i7sid/SkyNet-Dongle/bootloader/README.md

General Information
===================
This bootloader is based on
[openlpc-USB_Bootloader](https://github.com/openxc/openlpc-USB_Bootloader).

Some unnecessary parts where stripped off.
If you are looking for examples and openocd configuration,
please refer to openxc's repository.

All submodules have been included to simplify repository cloning and setup process.

For convenience a binary was added, that can be flashed directly onto LPC1769
even if there is no working arm toolchain installed.

You can simply flash the binary at  `src/bootloader.bin` to the device.
Afterwards the device should be detected by a host computer as a mass storage device.
Simply delete the file `firmware.bin` and upload another user application
(compiled for example with LPCXpresso IDE) in `bin`-format.
After resetting the device by unplugging and reinserting it the user application
should be executed.

All information from original repository following:

openlpc-USB_Bootloader
======================

This repository contains a USB bootloader compatible with the LPC17xx
microcontroller. The lineage of this bootloader:

* Originally based off of NXP's [AN10866 LPC1700 secondary
  bootloader](http://www.lpcware.com/content/nxpfile/an10866-lpc1700-secondary-usb-bootloader)
* Code Red modified the bootloader to use the BSD licensed LPCUSB library,
  instead of the restrictively licensed USB stack from Keil (which could only be
  used with the uVision/ARM development tools).
* Modifications made for OpenLPC project (not sure on the details)
* Chris Peplin replaced Code Red's fork of the LPCUSB library with a Git
  submodule pointing to a branch in the LPCUSB library that supports the
  LPC17xx, and re-used as many example files from the LPCUSB project directly.
* Chris also replaced the startup files with a Git submodule pointer to the ARM
  CDL project.
* Chris fixed an bug with non-sequntial writes that would break large-ish
  firmware writes.
* Chris added workarounds to allow flashing from all platforms from the CLI or a
  file browser (it's not exactly pretty, but it works - comments inline about
  the specific workarounds).

## Installing the Bootloader

    $ script/bootstrap.sh
    $ cd src
    $ make

Assuming you have an Olimex ARM-OCD-USB JTAG adapter plugged in, connected to
the board and the board powered up:

    $ make flash

If you are using an Olimex ARM-USB-OCD-H JTAG adapter, you need to specify a different interface:

    $ JTAG_INTERFACE=olimex-arm-usb-ocd-h make flash

## Building User Firmware

See the simple program in the `example` directory for an example of how to build
a program for the bootloader.

The only change required is your linker script - instead of starting the user
program at flash memory location 0, start it at `0x10000`, e.g.:

    FLASH (rx) : ORIGIN = 0x10000, LENGTH = 512K - 0x10000

If you are using the `SystemInit()` function from the ARM CDL, be aware that it
sets the vector table offset register (`VTOR`) back to `0`, so interrupts will
not work. A workaround is to manually set the `VTOR` to the location of your
interrupt vectors at startup:

    void Reset_Handler(void) {
        SystemInit();
        SCB->VTOR = (uint32_t) interrupt_vectors;
        ...
    }

This workaround doesn't have any negative effects if you use the same code
running on bare metal.

## Flashing User Code

Note that the `firmware.bin` file will always look the same (with an old
modification date and the same `firmware.bin` filename), even if you reflash and
remount the bootloader. It's not a true filesystem, we are just creating a fake
file so you can write to it from standard file browser tools.

### Windows

To flash, hold down the bootloader entry button while plugging into USB or
hitting the reset button. A USB drive should appear.

* Delete the firmware.bin file
* Copy your new firmware.bin over (the filename doesn't matter)
* Unmount and reset the microcontroller

### Mac OS X

To flash, hold down the bootloader entry button while plugging into USB or
hitting the reset button. A USB drive should appear.

**Using Finder**

* Delete the firmware.bin file
* Copy your new firmware.bin over (the filename doesn't matter)
* Eject and reset the microcontroller

**Command Line**

Open the Terminal app and run this to update the
firmware, assuming the file "newfirmware.bin" is in the current
directory and is the new version of the firmware you want to flash:

  $ cp newfirmware.bin /Volumes/LPC1759/firmware.bin

Eject and reset the microcontroller.

### Linux

There are two good options for flashing user firmware from Linux.

**USB Drive Method**

To flash, hold down the bootloader entry button while plugging into USB or
hitting the reset button. A USB drive should appear in your file manager (or you
can mount it manually with the `vfat` filesystem type).

* Delete the firmware.bin file
* Copy your new firmware.bin over (the filename doesn't matter)
* Unmount and reset the microcontroller

(These instructions are the same as Windows.)

Mounting the USB disk drive, deleting firmware.bin and copying over the new file
works fine now (after some bug fixes in the [original version of this
bootloader](http://dangerousprototypes.com/docs/LPC_ARM_quick_start#Bootloaders).

## License

The LPCUSB library is made availble under the BSD license. It is linked to from
this project as a Git submodule.

The core of the bootloader is originally developed by NXP, and is licensed under
NXP's odd example code license:

    Software that is described herein is for illustrative purposes only
    which provides customers with programming information regarding the
    products. This software is supplied "AS IS" without any warranties.
    NXP Semiconductors assumes no responsibility or liability for the
    use of the software, conveys no license or title under any patent,
    copyright, or mask work right to the product. NXP Semiconductors
    reserves the right to make changes in the software without
    notification. NXP Semiconductors also make no representation or
    warranty that such application will be suitable for the specified
    use without further testing or modification.

NXP claims no liability, but "conveys no license" which makes it not really open
source. Representatives of NXP have publicly stated that they are OK with the
examples being used and redistributed, so we use it here in good faith
([source](http://knowledgebase.nxp.com/showthread.php?t=2514&langid=2)).

A few remaining lines of code within other files pieces were developed by Code
Red, and are possibly available under a more restrictive license:

    The software is owned by Code Red Technologies and/or its suppliers, and is
    protected under applicable copyright laws.  All rights are reserved.  Any
    use in violation of the foregoing restrictions may subject the user to criminal
    sanctions under applicable laws, as well as to civil liability for the breach
    of the terms and conditions of this license.

    THIS SOFTWARE IS PROVIDED "AS IS".  NO WARRANTIES, WHETHER EXPRESS, IMPLIED
    OR STATUTORY, INCLUDING, BUT NOT LIMITED TO, IMPLIED WARRANTIES OF
    MERCHANTABILITY AND FITNESS FOR A PARTICULAR PURPOSE APPLY TO THIS SOFTWARE.
    USE OF THIS SOFTWARE FOR COMMERCIAL DEVELOPMENT AND/OR EDUCATION IS SUBJECT
    TO A CURRENT END USER LICENSE AGREEMENT (COMMERCIAL OR EDUCATIONAL) WITH
    CODE RED TECHNOLOGIES LTD.

Code Red has taken a public position that they are fine with redistributing the
code and including it in products, as long as the copyright message remains
intact so we use it here in good faith
([source](http://knowledgebase.nxp.trimm.net/showthread.php?p=12830)).
