i7sid/SkyNet-Dongle/case/v3.1.lowerCase.stl

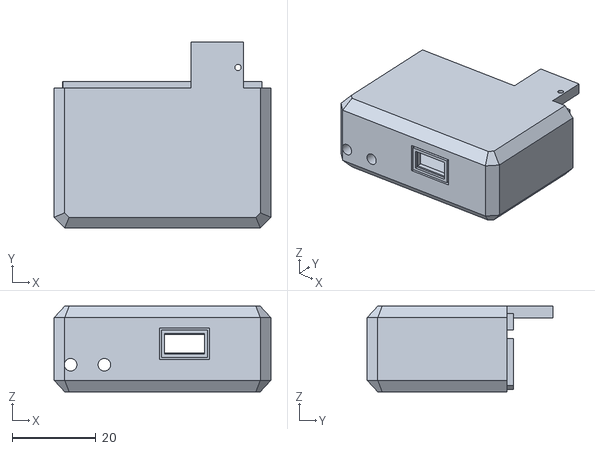
[picture p1: CAD file, 2015-02-09]
case/v3.1.lowerCase.stl
51.7 x 44.4 x 20.4
