i7sid/SkyNet-Dongle/case/v3.1.upperCase.stl

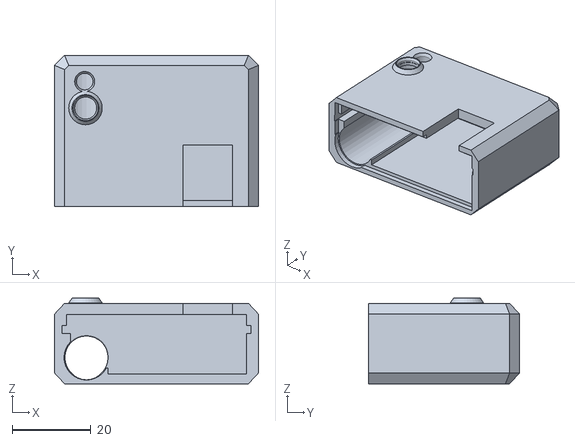
[picture p2: CAD file, 2015-02-09]
case/v3.1.upperCase.stl
51.7 x 38.4 x 21.7
