i7sid/SkyNet-Dongle/case/v3.1.button.stl

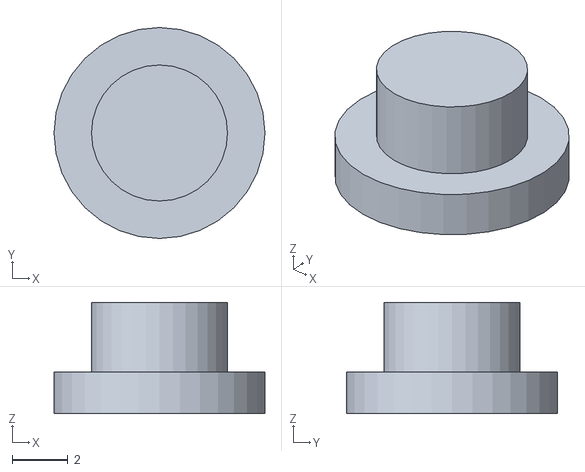
[picture p3: CAD file, 2015-01-29]
case/v3.1.button.stl
7.60 x 7.60 x 4.00
