i7sid/SkyNet-Dongle/board/SkyNetV3.1.brd

## EAGLE design board/SkyNetV3.1.brd (2015-10-10)

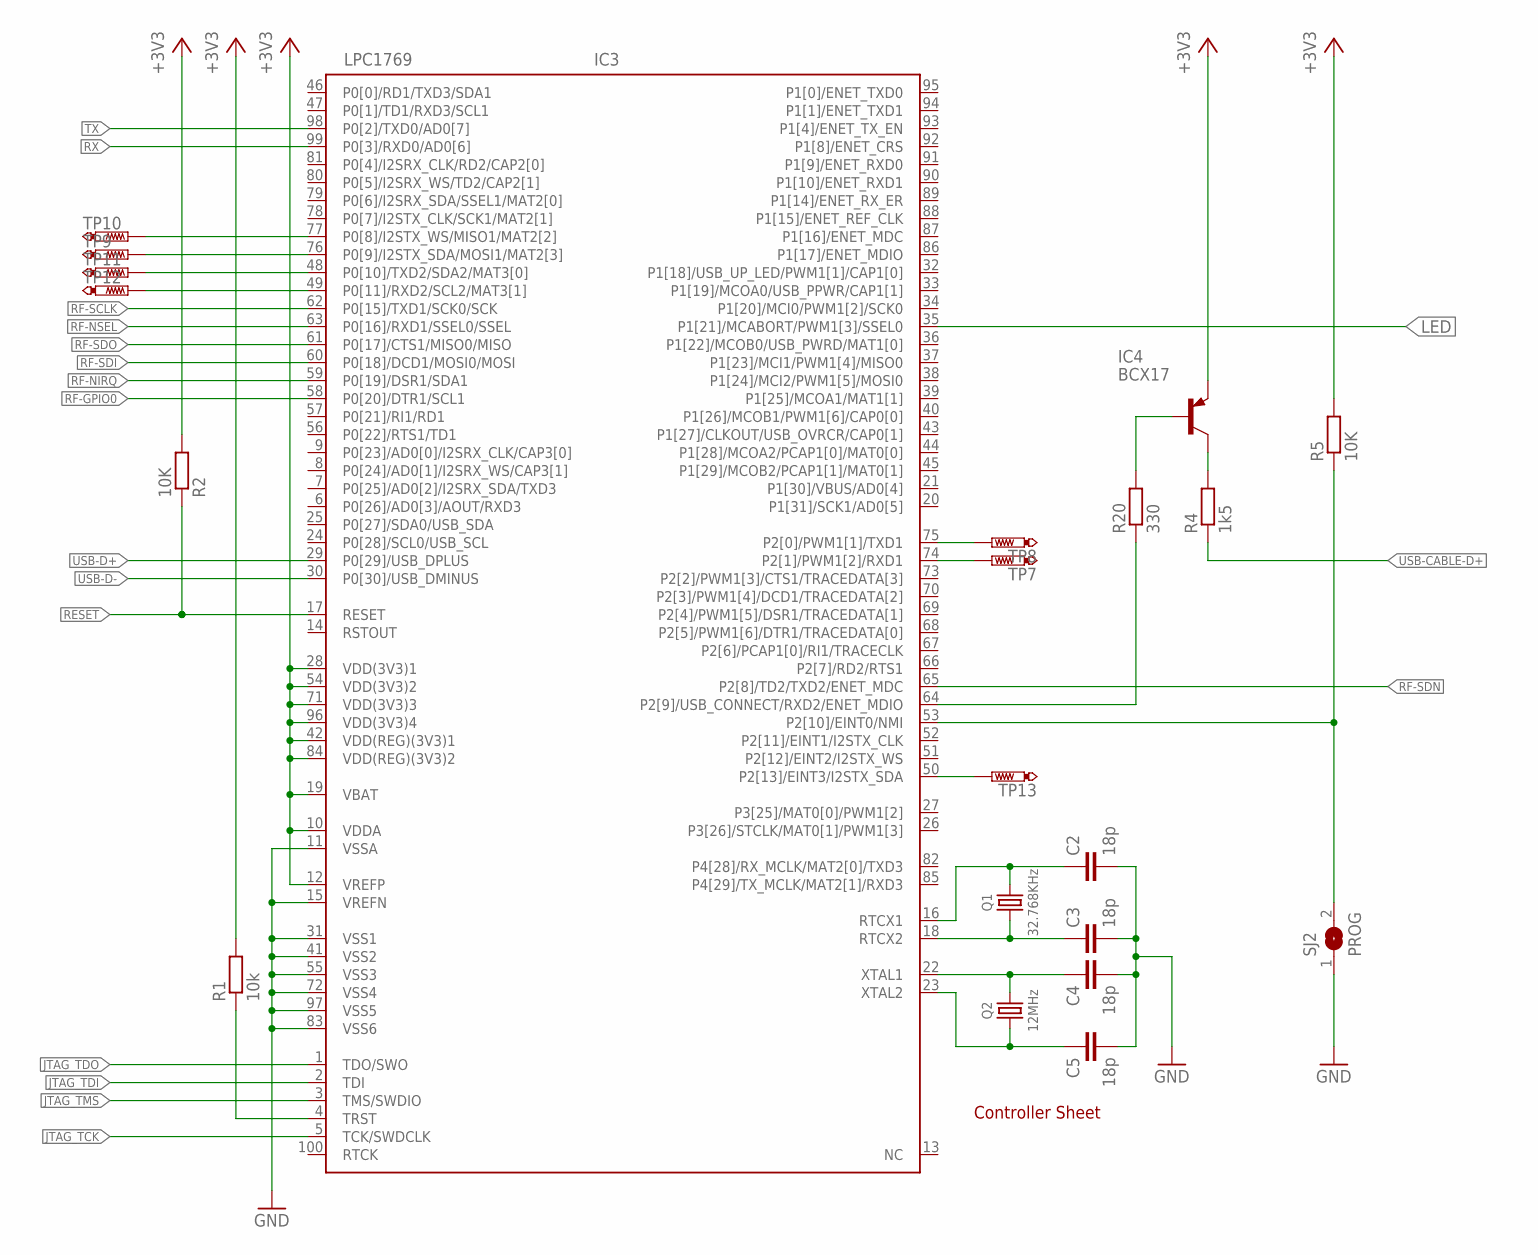
[picture p4: schematic SkyNetV3.1.sch, sheet 1, Controller]

Parts:
C2, C3, C4, C5: 18p; C0603
IC3: LPC1769; LQFP100-14X14
IC4: BCX17; SOT23
Q1: 32.768KHz; XTAL_49_18
Q2: 12MHz; XTAL_50_32
R1: 10k; R0603
R2, R5: 10K; R0603
R4: 1k5; R0603
R20: 330; R0603
SJ2: PROG; SJ
TP7, TP8, TP9, TP10, TP11, TP12, TP13: PTR1B1,27; B1,27

Connections:
+3V3: IC3.10 (VDDA), IC3.12 (VREFP), IC3.19 (VBAT), IC3.28 (VDD(3V3)1), IC3.42 (VDD(REG)(3V3)1), IC3.54 (VDD(3V3)2), IC3.71 (VDD(3V3)3), IC3.84 (VDD(REG)(3V3)2), IC3.96 (VDD(3V3)4), IC4.2 (E), R1.2, R2.2, R5.2; also elsewhere on the board
GND: C2.2, C3.2, C4.2, C5.2, IC3.11 (VSSA), IC3.15 (VREFN), IC3.31 (VSS1), IC3.41 (VSS2), IC3.55 (VSS3), IC3.72 (VSS4), IC3.83 (VSS6), IC3.97 (VSS5), SJ2.1; also elsewhere on the board
JTAG-TRST: IC3.4 (TRST), R1.1
JTAG_TCK: IC3.5 (TCK/SWDCLK); also elsewhere on the board
JTAG_TDI: IC3.2 (TDI); also elsewhere on the board
JTAG_TDO: IC3.1 (TDO/SWO); also elsewhere on the board
JTAG_TMS: IC3.3 (TMS/SWDIO); also elsewhere on the board
LED: IC3.35 (P1[21]/MCABORT/PWM1[3]/SSEL0); also elsewhere on the board
unnamed: IC3.75 (P2[0]/PWM1[1]/TXD1), TP8.TP
unnamed: IC3.76 (P0[9]/I2STX_SDA/MOSI1/MAT2[3]), TP9.TP
unnamed: IC3.77 (P0[8]/I2STX_WS/MISO1/MAT2[2]), TP10.TP
unnamed: IC3.74 (P2[1]/PWM1[2]/RXD1), TP7.TP
unnamed: IC3.49 (P0[11]/RXD2/SCL2/MAT3[1]), TP12.TP
unnamed: IC3.48 (P0[10]/TXD2/SDA2/MAT3[0]), TP11.TP
unnamed: IC3.50 (P2[13]/EINT3/I2STX_SDA), TP13.TP
PROG: IC3.53 (P2[10]/EINT0/NMI), R5.1, SJ2.2
RESET: IC3.17 (RESET), R2.1; also elsewhere on the board
RF-GPIO0: IC3.58 (P0[20]/DTR1/SCL1); also elsewhere on the board
RF-NIRQ: IC3.59 (P0[19]/DSR1/SDA1); also elsewhere on the board
RF-NSEL: IC3.63 (P0[16]/RXD1/SSEL0/SSEL); also elsewhere on the board
RF-SCLK: IC3.62 (P0[15]/TXD1/SCK0/SCK); also elsewhere on the board
RF-SDI: IC3.60 (P0[18]/DCD1/MOSI0/MOSI); also elsewhere on the board
RF-SDN: IC3.65 (P2[8]/TD2/TXD2/ENET_MDC); also elsewhere on the board
RF-SDO: IC3.61 (P0[17]/CTS1/MISO0/MISO); also elsewhere on the board
RTCX1: C2.1, IC3.16 (RTCX1), Q1.2
RTCX2: C3.1, IC3.18 (RTCX2), Q1.1
RX: IC3.99 (P0[3]/RXD0/AD0[6]); also elsewhere on the board
TX: IC3.98 (P0[2]/TXD0/AD0[7]); also elsewhere on the board
USB-CABLE-D+: R4.1; also elsewhere on the board
USB-CON: IC3.64 (P2[9]/USB_CONNECT/RXD2/ENET_MDIO), R20.1
USB-CON-TRANS: IC4.1 (B), R20.2
USB-CON-TRANS-2: IC4.3 (C), R4.2
USB-D+: IC3.29 (P0[29]/USB_DPLUS); also elsewhere on the board
USB-D-: IC3.30 (P0[30]/USB_DMINUS); also elsewhere on the board
XTAL1: C4.1, IC3.22 (XTAL1), Q2.3 (2)
XTAL2: C5.1, IC3.23 (XTAL2), Q2.1

Notes on the sheet:
Controller Sheet

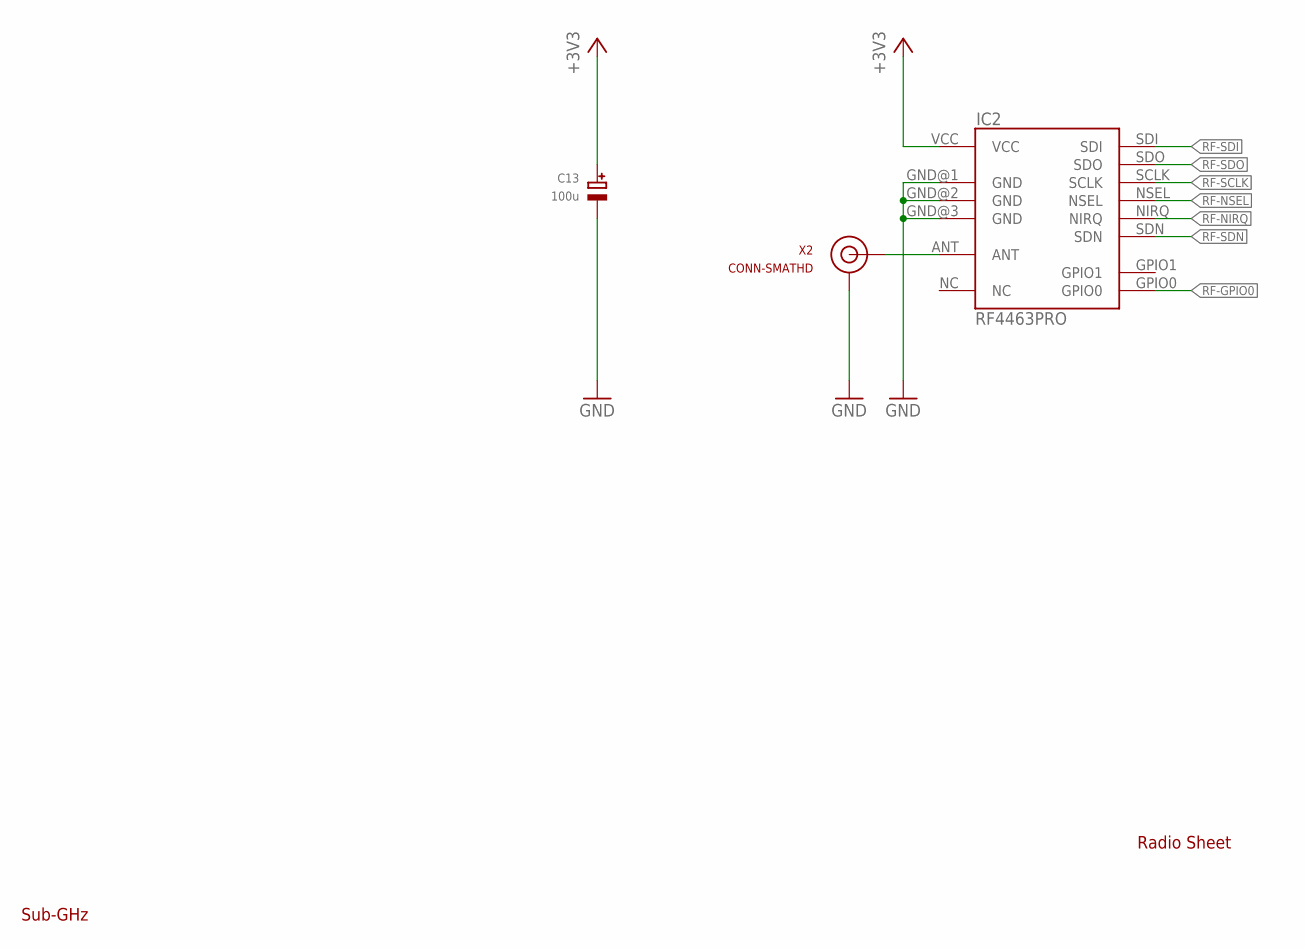
[picture p5: schematic SkyNetV3.1.sch, sheet 2, Radio]

Parts:
C13: 100u; EIA6032-28/C-W
IC2: RF4463PRO; STD_BOARD
X2: CONN-SMATHD; SMA-THD

Connections:
+3V3: C13.+, IC2.VCC; also elsewhere on the board
ANT: IC2.ANT, X2.SIG (SIGNAL)
GND: C13.-, IC2.GND@1 (GND), IC2.GND@2 (GND), IC2.GND@3 (GND), X2.GND@0 (GND), X2.GND@1 (GND), X2.GND@2 (GND), X2.GND@3 (GND); also elsewhere on the board
RF-GPIO0: IC2.GPIO0; also elsewhere on the board
RF-NIRQ: IC2.NIRQ; also elsewhere on the board
RF-NSEL: IC2.NSEL; also elsewhere on the board
RF-SCLK: IC2.SCLK; also elsewhere on the board
RF-SDI: IC2.SDI; also elsewhere on the board
RF-SDN: IC2.SDN; also elsewhere on the board
RF-SDO: IC2.SDO; also elsewhere on the board

Notes on the sheet:
Radio Sheet
Sub-GHz

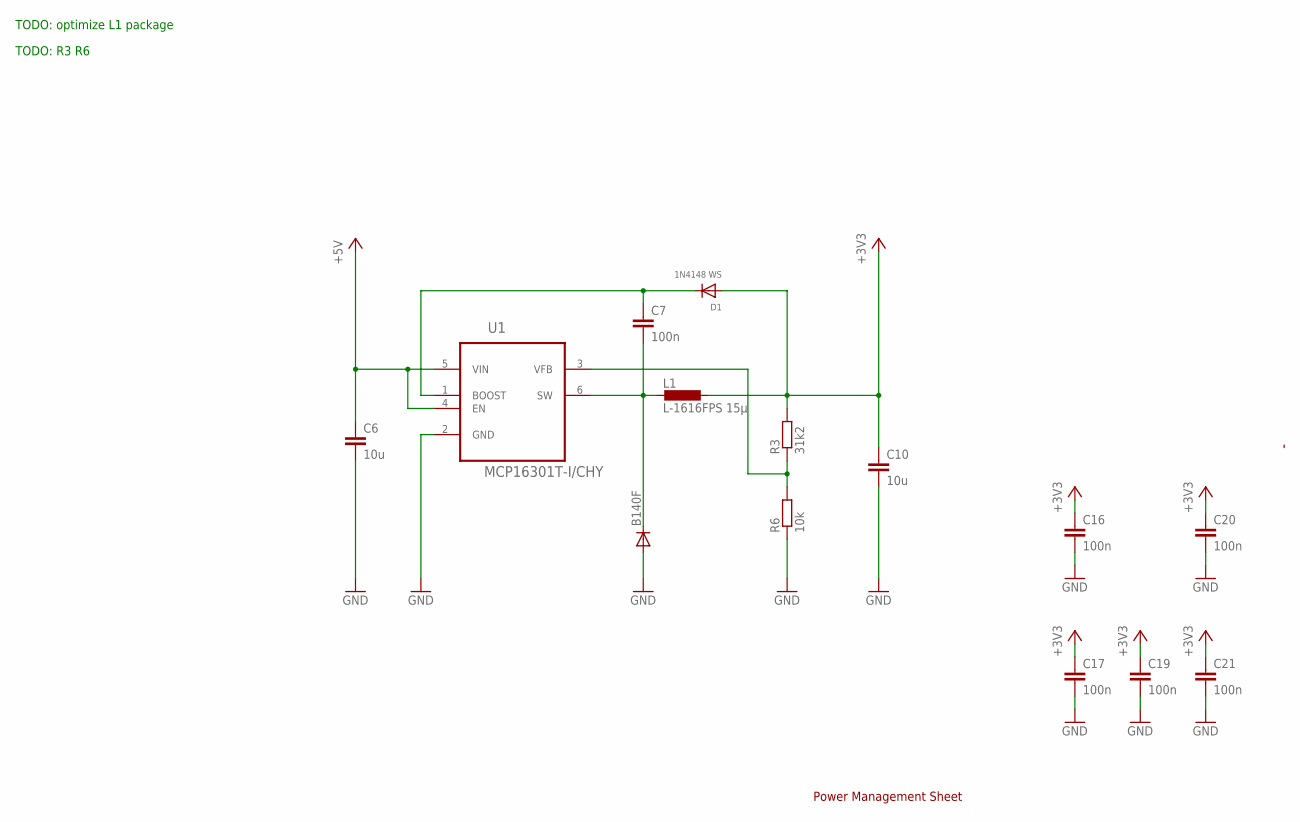
[picture p6: schematic SkyNetV3.1.sch, sheet 3, Power]

Parts:
B140F: DIODE-DO214AC; DO214AC
C6, C10: 10u; C0805
C7, C16, C17, C19, C20, C21: 100n; C0603
D1: 1N4148 WS; SOD-323
L1: L-1616FPS 15µ; LQH55D
R3: 31k2; R0603
R6: 10k; R0603
U1: MCP16301T-I/CHY; SOT95P290X145-6N

Connections:
+3V3: C10.1, C16.1, C17.1, C19.1, C20.1, C21.1, D1.A, L1.P$1 (1), R3.2; also elsewhere on the board
+5V: C6.1, U1.4 (EN), U1.5 (VIN); also elsewhere on the board
GND: B140F.A, C6.2, C10.2, C16.2, C17.2, C19.2, C20.2, C21.2, R6.1, U1.2 (GND); also elsewhere on the board
unnamed: B140F.C, C7.2, L1.P$2 (2), U1.6 (SW)
unnamed: C7.1, D1.C, U1.1 (BOOST)
unnamed: R3.1, R6.2, U1.3 (VFB)

Notes on the sheet:
Power Management Sheet
TODO: optimize L1 package
TODO: R3 R6

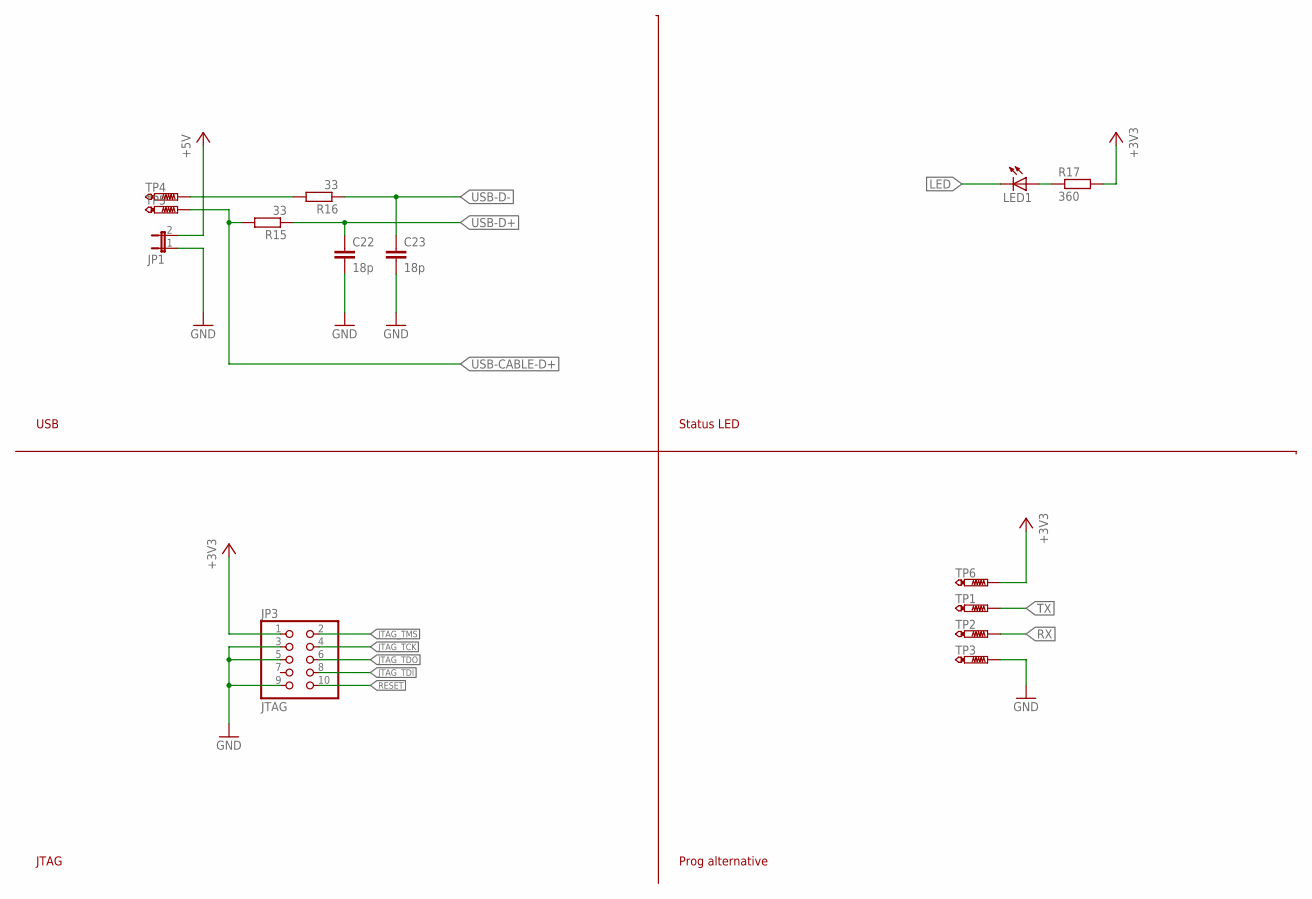
[picture p7: schematic SkyNetV3.1.sch, sheet 4, Interface]

Parts:
C22, C23: 18p; C0603
JP1: JP1E; JP1
JP3: JTAG; 2X05_1.27MM_SMT
LED1: LEDCHIP-LED0805; CHIP-LED0805
R15, R16: 33; R0603
R17: 360; R0603
TP1, TP2, TP4, TP5: PTR1B1,27; B1,27
TP3, TP6: PTR1B2,54; B2,54

Connections:
+3V3: JP3.1, R17.2, TP6.TP; also elsewhere on the board
+5V: JP1.2; also elsewhere on the board
GND: C22.2, C23.2, JP1.1, JP3.3, JP3.5, JP3.9, TP3.TP; also elsewhere on the board
JTAG_TCK: JP3.4; also elsewhere on the board
JTAG_TDI: JP3.8; also elsewhere on the board
JTAG_TDO: JP3.6; also elsewhere on the board
JTAG_TMS: JP3.2; also elsewhere on the board
LED: LED1.C; also elsewhere on the board
LED-R-R: LED1.A, R17.1
RESET: JP3.10; also elsewhere on the board
RX: TP2.TP; also elsewhere on the board
TX: TP1.TP; also elsewhere on the board
USB-CABLE-D+: R15.2, TP5.TP; also elsewhere on the board
USB-CABLE-D-: R16.2, TP4.TP
USB-D+: C22.1, R15.1; also elsewhere on the board
USB-D-: C23.1, R16.1; also elsewhere on the board

Notes on the sheet:
USB
Status LED
Prog alternative
JTAG

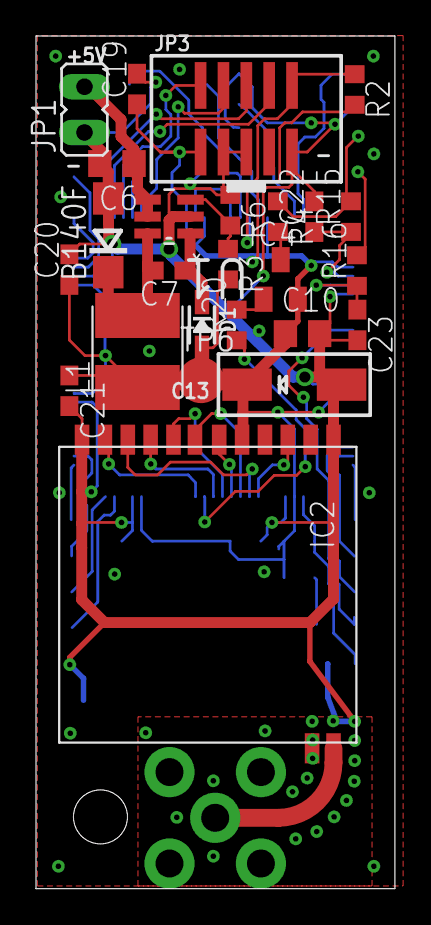
[picture p8: board SkyNetV3.1.brd from above]

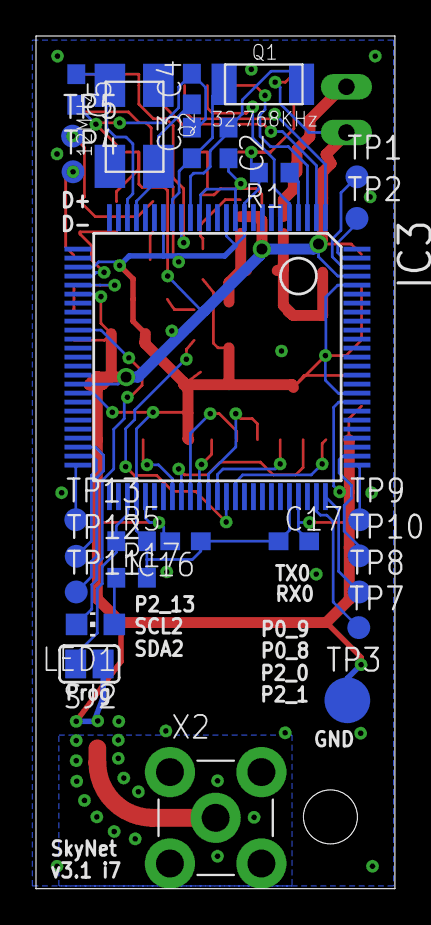
[picture p9: board SkyNetV3.1.brd from below]

Board: 2 copper layers, 19.9 x 47.4 mm, 52 parts (27 on the bottom side), 43 nets.
