i7sid/SkyNet-Dongle/board_breakout/board_breakout.brd

## EAGLE design board_breakout/board_breakout.brd (2015-02-02)

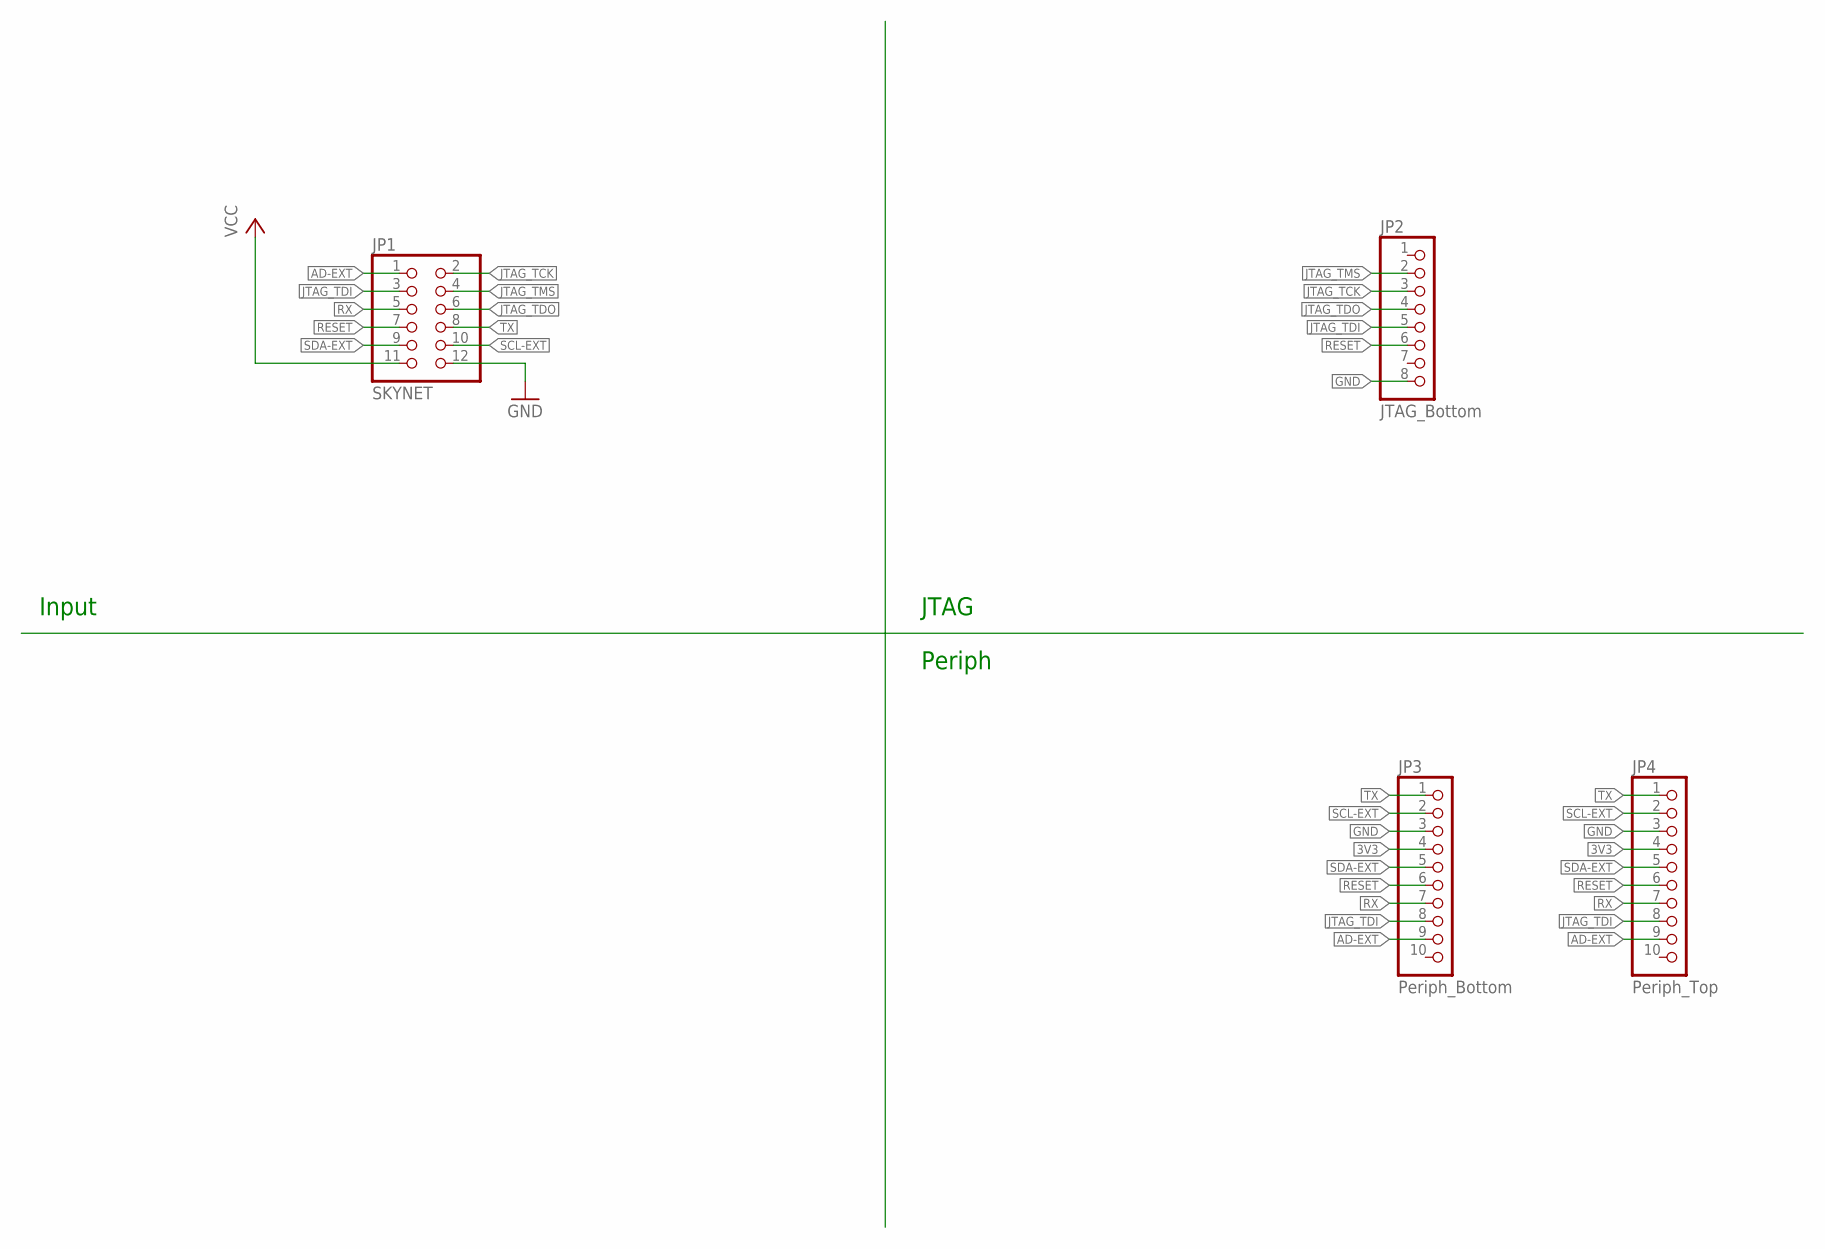
[picture p10: schematic board_breakout.sch]

Parts:
JP1: SKYNET; 2X06M
JP2: JTAG_Bottom; 1X08
JP3: Periph_Bottom; 1X10
JP4: Periph_Top; 1X10_SMT

Connections:
3V3: JP1.11, JP3.4, JP4.4
AD-EXT: JP1.1, JP3.9, JP4.9
GND: JP1.12, JP2.8, JP3.3, JP4.3
JTAG_TCK: JP1.2, JP2.3
JTAG_TDI: JP1.3, JP2.5, JP3.8, JP4.8
JTAG_TDO: JP1.6, JP2.4
JTAG_TMS: JP1.4, JP2.2
RESET: JP1.7, JP2.6, JP3.6, JP4.6
RX: JP1.5, JP3.7, JP4.7
SCL-EXT: JP1.10, JP3.2, JP4.2
SDA-EXT: JP1.9, JP3.5, JP4.5
TX: JP1.8, JP3.1, JP4.1

Notes on the sheet:
Input
JTAG
Periph

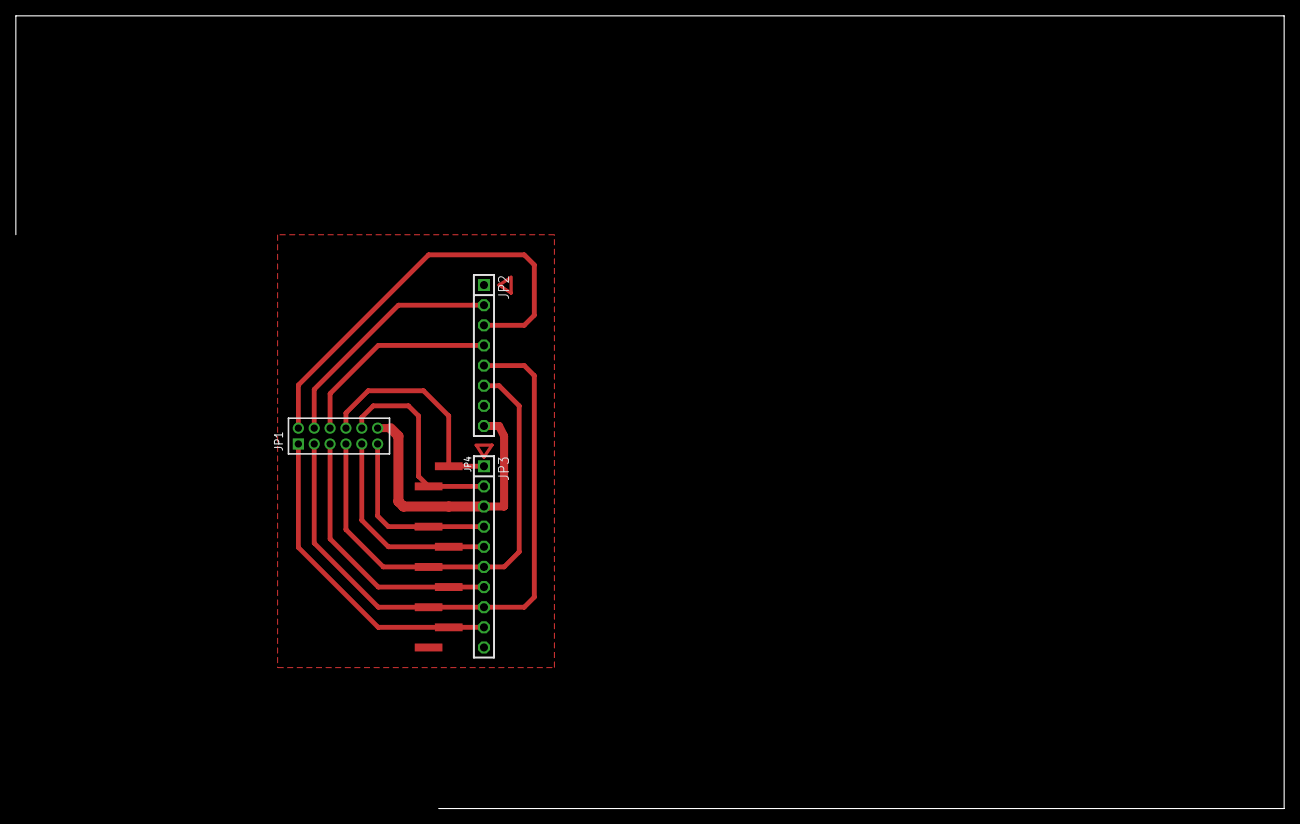
[picture p11: board board_breakout.brd from above]

Board: 2 copper layers, 4 parts (0 on the bottom side), 12 nets.
