i7sid/SkyNet-Dongle/usb2seriel/usb2rs232_v2.3.brd

## EAGLE design usb2seriel/usb2rs232_v2.3.brd (2014-06-16)

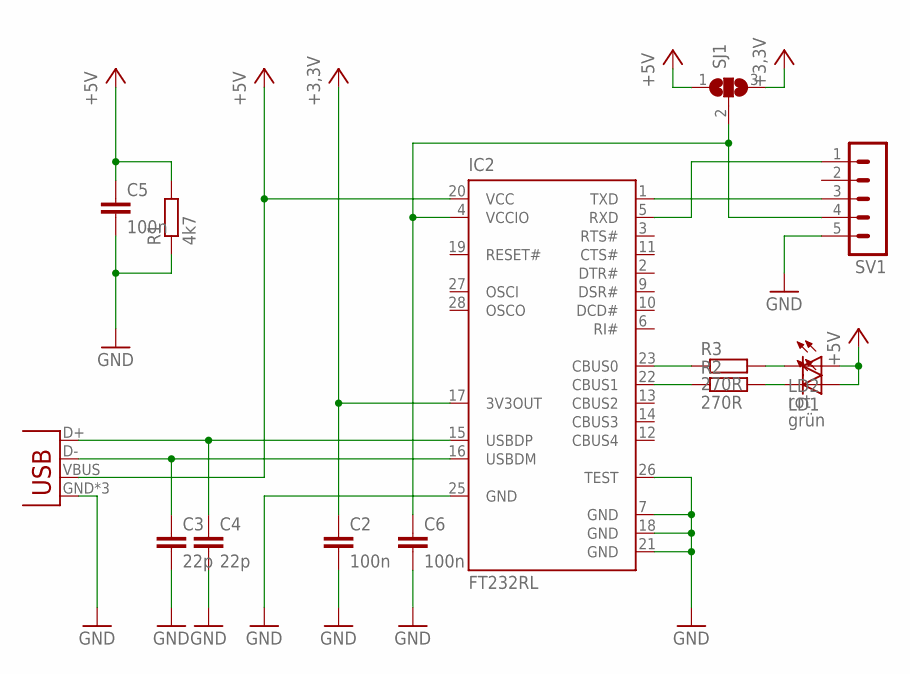
[picture p12: schematic usb2rs232_v2.3.sch]

Parts:
C2, C5, C6: 100n; C0603
C3, C4: 22p; C0603
IC2: FT232RL; SSOP28
JP2: USB-MICROB
LD1: grün; CHIP-LED0603
LD2: rot; CHIP-LED0603
R1: 4k7; R0603
R2, R3: 270R; R0603
SJ1: SJ2W; SJ_2
SV1: MA05-1

Connections:
+3,3V: C2.1, IC2.17 (3V3OUT), SJ1.3
+5V: C5.1, IC2.20 (VCC), JP2.VBUS, LD1.A, LD2.A, R1.2, SJ1.1
GND: C2.2, C3.2, C4.2, C5.2, C6.2, IC2.7 (GND), IC2.18 (GND), IC2.21 (GND), IC2.25 (GND), IC2.26 (TEST), JP2.GND, JP2.MT1 (GND), JP2.MT2 (GND), R1.1, SV1.5
unnamed: IC2.23 (CBUS0), R3.1
unnamed: IC2.22 (CBUS1), R2.1
unnamed: C4.1, IC2.15 (USBDP), JP2.D+
unnamed: C3.1, IC2.16 (USBDM), JP2.D-
unnamed: C6.1, IC2.4 (VCCIO), SJ1.2, SV1.4
unnamed: LD1.C, R2.2
unnamed: LD2.C, R3.2
unnamed: IC2.5 (RXD), SV1.1
unnamed: IC2.1 (TXD), SV1.3

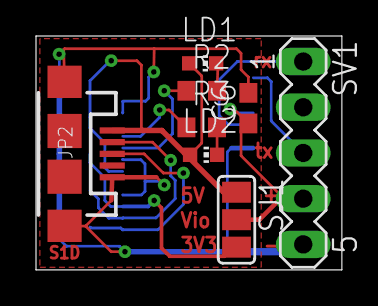
[picture p13: board usb2rs232_v2.3.brd from above]

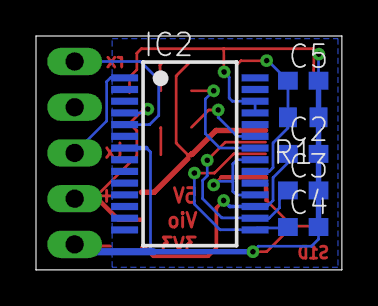
[picture p14: board usb2rs232_v2.3.brd from below]

Board: 2 copper layers, 17.0 x 13.0 mm, 14 parts (6 on the bottom side), 12 nets.
