i7sid/SkyNet-Dongle/firmware/src/gpio/gpio_irq.c

/**@file
 * gpio_irq.c
 *
 *  Created on: 27.04.2015
 *      Author: christoph
 *
 *      @brief Functionality for GPIO Interrupts
 */

#include "gpio_irq.h"

#include "../basestation/wind/windspeed/windspeed.h"
#include "../radio/skynet_radio.h"

void GPIO_IRQ_HANDLER(void) {

	// WARNING: DO NOT MAKE ANY DEBUG OUTPUTS IN HERE!
	// The timing receiving long packets is very fragile!
	// Every DBG takes too much time and leads to broken packet reception!

#if 0
	if (Chip_GPIOINT_GetStatusFalling(LPC_GPIOINT, GPIOINT_PORT0) & (1 << 19)) {
		radio_packet_handler();
		Chip_GPIOINT_ClearIntStatus(LPC_GPIOINT, GPIOINT_PORT0, (1 << 19));
	}
#endif

	if (Chip_GPIOINT_GetStatusFalling(LPC_GPIOINT, GPIOINT_PORT2) & (1 << 13)) {
		//handels the interrups from the windcups of the basestation
		skynetbase_windspeed_tickhandler();
		Chip_GPIOINT_ClearIntStatus(LPC_GPIOINT, GPIOINT_PORT2, (1 << 13));
	}
	//LPC_SYSCTL->EXTINT |= (1<<EINT3);	// reset IRQ state
	NVIC_ClearPendingIRQ(EINT3_IRQn);

}

void enable_gpio_irq(int port, int channel){
	NVIC_DisableIRQ(EINT3_IRQn);
	if(port == 0){
		uint32_t irqmaskset = Chip_GPIOINT_GetIntFalling(LPC_GPIOINT,GPIOINT_PORT0); // get gpio irq mask
		irqmaskset |= (1 << channel); //set bit channel
		Chip_GPIOINT_SetIntFalling(LPC_GPIOINT, GPIOINT_PORT0, irqmaskset); //enable irq
	}else if(port == 2){
		uint32_t irqmaskset = Chip_GPIOINT_GetIntFalling(LPC_GPIOINT,GPIOINT_PORT2); // get gpio irq mask
		irqmaskset |= (1 << channel); //set bit channel
		Chip_GPIOINT_SetIntFalling(LPC_GPIOINT, GPIOINT_PORT2, irqmaskset); //enable irq

	}else{
		DBG("enable_gpio_irq: wrong port number!\n");
	}
	NVIC_EnableIRQ(EINT3_IRQn);

}

void disable_gpio_irq(int port, int channel){
	NVIC_DisableIRQ(EINT3_IRQn);

	if(port == 0){
		uint32_t irqmaskclear = Chip_GPIOINT_GetIntFalling(LPC_GPIOINT,GPIOINT_PORT0); // get gpio irq mask
		irqmaskclear &= ~(1 << channel); // clear bit channel
		Chip_GPIOINT_SetIntFalling(LPC_GPIOINT, GPIOINT_PORT0, irqmaskclear); //disable irq
	}else if(port == 2){
		uint32_t irqmaskclear = Chip_GPIOINT_GetIntFalling(LPC_GPIOINT,GPIOINT_PORT2); // get gpio irq mask
		irqmaskclear &= ~(1 << channel); // clear bit channel
		Chip_GPIOINT_SetIntFalling(LPC_GPIOINT, GPIOINT_PORT2, irqmaskclear); //disable irq
	}else{
		DBG("disable_gpio_irq: wrong port number!\n");
	}

	NVIC_EnableIRQ(EINT3_IRQn);

}
