i7sid/SkyNet-Dongle/firmware/src/radio/skynet_radio.c

/**
 * @file
 *
 * @date	01.07.2014
 * @author	Michael Zapf <michael.zapf@fau.de>
 *
 * @brief	Contains functionality for communication with RF module.
 */

#if 0

#include <string.h>
#include <stdlib.h>

#include "skynet_radio.h"
#include "radio_config.h"
#include "radio_hal.h"
#include "../spi/spi.h"
#include "../cpu/systick.h"
#include "../misc/event_queue.h"
#include "../periph/led.h"
#include "../gpio/gpio_irq.h"

uint8_t bMain_IT_Status;
uint8_t pwrLvlIdx = 0;
uint8_t pwrLvl[] = {8,12,19,35,127};	//0, 5, 10, 15, 20 dBm
char timeStr[] = {0, 0, 0, 0, 0, 0};

volatile bool radio_initialized = false;

#undef DEBUG

void radio_start_rx(void) {
	vRadio_StartRX(pRadioConfiguration->Radio_ChannelNumber, 0x0);
	DBG("Radio RX started.\n");
}

void radio_pin_init(void) {
	// "on/off" pin
	Chip_GPIO_SetPinDIROutput(LPC_GPIO, RADIO_ON_PORT, RADIO_ON_PIN);
	Chip_GPIO_SetPinState(LPC_GPIO, RADIO_ON_PORT, RADIO_ON_PIN, true);
	//Chip_GPIO_SetPinState(LPC_GPIO, RADIO_ON_PORT, RADIO_ON_PIN, false);
}

void radio_init(void) {
	radio_pin_init();
	Chip_GPIOINT_Init(LPC_GPIOINT);

	// "on/off" pin
	Chip_GPIO_SetPinState(LPC_GPIO, RADIO_ON_PORT, RADIO_ON_PIN, false);

	vRadio_Init();	// intialize radio chip

	si446x_part_info();
	si446x_func_info();


	DBG("--- radio chip version information following ---\n");
	DBG("CHIPREV:   0x%x\n", Si446xCmd.PART_INFO.CHIPREV);
	DBG("CUSTOMER:  0x%x\n", Si446xCmd.PART_INFO.CUSTOMER);
	DBG("ID:        0x%x\n", Si446xCmd.PART_INFO.ID);
	DBG("PART:      0x%x\n", Si446xCmd.PART_INFO.PART);
	DBG("PBUILD:    0x%x\n", Si446xCmd.PART_INFO.PBUILD);
	DBG("ROMID:     0x%x\n", Si446xCmd.PART_INFO.ROMID);

	DBG("FUNC:      0x%x\n", Si446xCmd.FUNC_INFO.FUNC);
	DBG("PATCH:     0x%x\n", Si446xCmd.FUNC_INFO.PATCH);
	DBG("REVBRANCH: 0x%x\n", Si446xCmd.FUNC_INFO.REVBRANCH);
	DBG("REVEXT:    0x%x\n", Si446xCmd.FUNC_INFO.REVEXT);
	DBG("REVINT:    0x%x\n", Si446xCmd.FUNC_INFO.REVINT);
	DBG("------ end radio chip version information ------\n");


	// This interrupt should have highest priority to assure that we do not miss packets
	NVIC_SetPriority(EINT3_IRQn, 0);
	radio_set_irq();

	// start receiving...
	//vRadio_StartRXlong(pRadioConfiguration->Radio_ChannelNumber);
	//vRadio_StartRX(pRadioConfiguration->Radio_ChannelNumber, 0);
	//DBG("Radio RX started.\n");
}

void radio_shutdown(void) {
	radio_unset_irq();
	radio_hal_AssertShutdown();
	SPI_Deinit();

	Chip_GPIO_SetPinState(LPC_GPIO, RADIO_ON_PORT, RADIO_ON_PIN, true);
	//Chip_GPIO_SetPinState(LPC_GPIO, RADIO_ON_PORT, RADIO_ON_PIN, false);
}

void radio_set_irq(void) {
	Chip_GPIOINT_SetIntFalling(LPC_GPIOINT, GPIOINT_PORT0, (1 << 19));
	Chip_GPIOINT_ClearIntStatus(LPC_GPIOINT, GPIOINT_PORT0, (1 << 19));
	NVIC_ClearPendingIRQ(EINT3_IRQn);
	NVIC_EnableIRQ(EINT3_IRQn);


}

void radio_unset_irq(void) {
	NVIC_ClearPendingIRQ(EINT3_IRQn);
	NVIC_DisableIRQ(EINT3_IRQn);
}

void radio_disable_irq(void){
	disable_gpio_irq(0,19);
}

void radio_enable_irq(void){
	enable_gpio_irq(0,19);
}

void radio_reset_packet_size(void) {
	// Field 2 length
	Si446xCmd.GET_PROPERTY.DATA0 = 0x1F;
	Si446xCmd.GET_PROPERTY.DATA1 = 0xFF;
	si446x_set_property_lpc(0x12, 2, 0x11);
}

// for neccessarity of this function refer to errata sheet
static void tx_fifo_reset_fixed(void) {
	// send reset command
	si446x_fifo_info(SI446X_CMD_FIFO_INFO_ARG_TX_BIT);

	// fill one dummy byte
	uint8_t n = 0;
	si446x_write_tx_fifo(1, &n);

	// send reset request again
	si446x_fifo_info(SI446X_CMD_FIFO_INFO_ARG_TX_BIT);
}

void radio_send_variable_packet(uint8_t *packet, uint16_t length)
{
	uint8_t data[length+2];

	//radio_disable_irq();
	__disable_irq();

	// Leave RX state
	si446x_change_state(SI446X_CMD_CHANGE_STATE_ARG_NEW_STATE_ENUM_READY);

	// Reset the Tx Fifo
	tx_fifo_reset_fixed();

	// Read ITs, clear pending ones
	si446x_get_int_status(0u, 0u, 0u);

	// copy payload data to send buffer
	memcpy(data+2, packet, length);


	// Field 1 length
	Si446xCmd.GET_PROPERTY.DATA0 = 0x0;
	Si446xCmd.GET_PROPERTY.DATA1 = 0x2;
	si446x_set_property_lpc(0x12, 2, 0x0D);

	// Field 2 length
	Si446xCmd.GET_PROPERTY.DATA0 = length >> 8;
	Si446xCmd.GET_PROPERTY.DATA1 = length & 0xFF;
	si446x_set_property_lpc(0x12, 2, 0x11);

	// TODO DEBUG
	/*
	if (length < 50) {
		for (uint16_t i = 0; i < length + 2; ++i) {
			DBG("%02x ", data[i]);
		}
		DBG("\n");
	}
*/

	data[0] = length >> 8;
	data[1] = length & 0xFF;

	int16_t remaining = length+2;
	uint8_t* ptr = data;
	volatile bool first_run = true;
	while(remaining > 0) {
		uint8_t nowLength;
		//if (first_run) {
		if (first_run && (uint16_t)RADIO_MAX_PACKET_LENGTH <= remaining) {
			nowLength = RADIO_MAX_PACKET_LENGTH;
		}
		else if (first_run && (uint16_t)RADIO_MAX_PACKET_LENGTH > remaining) {
			nowLength = remaining;
		}
		else if ((uint16_t)RADIO_TX_ALMOST_EMPTY_THRESHOLD < remaining) {
			nowLength = RADIO_TX_ALMOST_EMPTY_THRESHOLD;
		}
		else {
			nowLength = remaining;
		}

		// Fill the TX fifo with datas
		si446x_write_tx_fifo(nowLength, ptr);
		ptr += nowLength;
		remaining -= nowLength;

		if (first_run) {
			si446x_start_tx(pRadioConfiguration->Radio_ChannelNumber, 0x30, 0x0);
			first_run = false;
		}

		while (true) {
			si446x_get_int_status(0u, 0u, 0u);

			//			if (Si446xCmd.GET_INT_STATUS.CHIP_STATUS & SI446X_CMD_GET_INT_STATUS_REP_FIFO_UNDERFLOW_OVERFLOW_ERROR_BIT ||
			//					Si446xCmd.GET_INT_STATUS.CHIP_STATUS & SI446X_CMD_GET_INT_STATUS_REP_CMD_ERROR_BIT) {
			if (Si446xCmd.GET_INT_STATUS.CHIP_PEND & SI446X_CMD_GET_INT_STATUS_REP_FIFO_UNDERFLOW_OVERFLOW_ERROR_BIT ||
					Si446xCmd.GET_INT_STATUS.CHIP_STATUS & SI446X_CMD_GET_INT_STATUS_REP_CMD_ERROR_BIT) {

				DBG("[ERROR] RF chip reported error while sending.\n");

				// reset chip to assure correct behaviour next time
				events_enqueue(EVENT_RADIO_RESTART, NULL);

				return;
			}
			else if (Si446xCmd.GET_INT_STATUS.PH_PEND & SI446X_CMD_GET_INT_STATUS_REP_PACKET_SENT_BIT) {
				if (remaining > 0) {
					// ERROR CASE! PACKET_SENT interrupt occurred,
					// even if not all remaining bytes have been put to FIFO
					DBG("[ERROR] PACKET_SENT, but remaining: %d\n", remaining);
					//skynet_led_blink_red_passive(1000);

					// clear remaining bytes to avoid pushing further bytes to FIFO
					remaining = 0;
				}

				break;
			}
			else if (Si446xCmd.GET_INT_STATUS.PH_PEND & SI446X_CMD_GET_INT_STATUS_REP_TX_FIFO_ALMOST_EMPTY_BIT) {
				// not all bytes sent yet, but chip is ready to receive more
				if (remaining > 0) break;
			}
		}


	}
	//DBG("remaining: %d\n", remaining);

	radio_reset_packet_size(); // reset size of Field 2
	si446x_fifo_info(SI446X_CMD_FIFO_INFO_ARG_TX_BIT | SI446X_CMD_FIFO_INFO_ARG_RX_BIT);
	uint8_t ebuf[64];
	memset(ebuf, 0, sizeof(ebuf));
	si446x_write_tx_fifo(64, ebuf);
	si446x_fifo_info(SI446X_CMD_FIFO_INFO_ARG_TX_BIT | SI446X_CMD_FIFO_INFO_ARG_RX_BIT);

	radio_enable_irq();
	__enable_irq();

	vRadio_StartRX(pRadioConfiguration->Radio_ChannelNumber, 0x0);
}




void radio_packet_handler(void) {
	si446x_get_int_status(0u, 0u, 0u);

	radio_disable_irq();

	// error occurred
	if (Si446xCmd.GET_INT_STATUS.PH_PEND & SI446X_CMD_GET_INT_STATUS_REP_FIFO_UNDERFLOW_OVERFLOW_ERROR_BIT ||
			Si446xCmd.GET_INT_STATUS.CHIP_STATUS & SI446X_CMD_GET_INT_STATUS_REP_CMD_ERROR_BIT) {

		//DBG("[ERROR] RF chip reported error by interrupt: %d.\n", Si446xCmd.GET_INT_STATUS.CHIP_STATUS);
		DBG("[ERROR] %d\n", Si446xCmd.GET_INT_STATUS.CHIP_STATUS);

		// reset chip to assure correct behaviour next time
		//events_enqueue(EVENT_RADIO_RESTART, NULL);

		// reset FIFOs
		tx_fifo_reset_fixed();
		si446x_fifo_info(SI446X_CMD_FIFO_INFO_ARG_TX_BIT | SI446X_CMD_FIFO_INFO_ARG_RX_BIT);
		vRadio_StartRX(pRadioConfiguration->Radio_ChannelNumber, 0x0);

		return;
	}
	// CRC checksum fail
	else if (Si446xCmd.GET_INT_STATUS.PH_PEND & SI446X_CMD_GET_INT_STATUS_REP_CRC_ERROR_BIT) {
		DBG("CRC error.\n");
	}
	// Packet beginning or completely received
	else if (Si446xCmd.GET_INT_STATUS.PH_PEND & SI446X_CMD_GET_INT_STATUS_REP_RX_FIFO_ALMOST_FULL_BIT ||
			Si446xCmd.GET_INT_STATUS.PH_PEND & SI446X_CMD_GET_INT_STATUS_REP_PACKET_RX_BIT) {
		uint16_t length_low;
		uint16_t length_high;
		uint16_t length;

		si446x_get_packet_info(0x0, 0x0, 0x0);
		length_low = Si446xCmd.PACKET_INFO.LENGTH_7_0;
		length_high = (Si446xCmd.PACKET_INFO.LENGTH_15_8 & 0xFF);
		length = (length_high << 8) + length_low;

		uint8_t data[length+1];
		data[length] = 0;		// terminate with null character
		uint8_t* ptr = data;

		uint16_t remaining = length;
		bool abort = false;
		while (remaining > 0) {
			uint8_t nowLength;
			if (remaining > 0xFF || RADIO_RX_ALMOST_FULL_THRESHOLD < remaining) {
				nowLength = RADIO_RX_ALMOST_FULL_THRESHOLD;
			}
			else {
				nowLength = remaining;
			}

			// read current data from RX FIFO
			si446x_read_rx_fifo(nowLength, ptr);
			ptr += nowLength;
			remaining -= nowLength;

			while (true) {
				si446x_get_int_status(0u, 0u, 0u);

//				if (Si446xCmd.GET_INT_STATUS.PH_PEND & SI446X_CMD_GET_INT_STATUS_REP_PACKET_RX_BIT) {
				if (Si446xCmd.GET_INT_STATUS.PH_STATUS & SI446X_CMD_GET_INT_STATUS_REP_PACKET_RX_BIT) {
					//DBG("RECEIVED, remaining: %d\n", remaining);
					break;
				}
				else if (Si446xCmd.GET_INT_STATUS.PH_PEND & SI446X_CMD_GET_INT_STATUS_REP_RX_FIFO_ALMOST_FULL_BIT) {
					break;
				}
				else if (Si446xCmd.GET_INT_STATUS.PH_PEND & SI446X_CMD_GET_INT_STATUS_REP_FIFO_UNDERFLOW_OVERFLOW_ERROR_BIT) {
					// too many bytes read, perhaps a corrupt packet was received
					abort = true;
					remaining = 0;
					break;
				}
			}
		}

		if (!abort) {
			ptr = data;

			// copy packet
			int copy_length = length;
			if ((uint16_t)SKYNET_RADIO_MAX_SIZE >= length) {
				skynet_packet *pkt = malloc(sizeof(skynet_packet));	malloc_count();
				char* newdata = malloc(copy_length * sizeof(char));	malloc_count();
				if (pkt != NULL) {
					memcpy(newdata, data, copy_length);
					pkt->data = newdata;
					pkt->length = copy_length;

					// TODO prüfen/ unterscheiden, ob es DATA oder ACK o.ä. ist
					//		nur DATAs sollen in die event_queue, ACKs werden in received_ack gespeichert

					events_enqueue(EVENT_RF_GOT_PACKET, pkt);
				}
				else {
					// TODO: ERROR, could not malloc memory
				}
			}
			/*
			else {
				//copy_length = SKYNET_RADIO_MAX_SIZE;
			}
			*/
		}

		vRadio_StartRX(pRadioConfiguration->Radio_ChannelNumber, 0x0);
	}

	radio_enable_irq();
}

INLINE bool radio_get_gpio0(void) {
	return Chip_GPIO_GetPinState(LPC_GPIO, SI_LIB_GPIO0_PORT, SI_LIB_GPIO0_PIN);
}

void radio_config_for_clock_measurement() {
	si446x_get_property(0x0, 1, 1);
	DBG("GLOBAL_CLK_CFG: %x\n", Si446xCmd.GET_PROPERTY.DATA0);

	Si446xCmd.GET_PROPERTY.DATA0 = 0b01110000; // enable clock output and divide by 30
	si446x_set_property_lpc(0x0, 1, 1);

	si446x_get_property(0x0, 1, 1);
	DBG("GLOBAL_CLK_CFG: %x\n", Si446xCmd.GET_PROPERTY.DATA0);

	si446x_gpio_pin_cfg(0x7, 0x0, 0x0, 0x0, 0x0, 0x0, 0x0);
}

void si446x_set_property_lpc( uint8_t GROUP, uint8_t NUM_PROPS, uint8_t START_PROP)
{
	Pro2Cmd[0] = SI446X_CMD_ID_SET_PROPERTY;
	Pro2Cmd[1] = GROUP;
	Pro2Cmd[2] = NUM_PROPS;
	Pro2Cmd[3] = START_PROP;
	Pro2Cmd[4] = Si446xCmd.GET_PROPERTY.DATA0;
	Pro2Cmd[5] = Si446xCmd.GET_PROPERTY.DATA1;
	Pro2Cmd[6] = Si446xCmd.GET_PROPERTY.DATA2;
	Pro2Cmd[7] = Si446xCmd.GET_PROPERTY.DATA3;
	Pro2Cmd[8] = Si446xCmd.GET_PROPERTY.DATA4;
	Pro2Cmd[9] = Si446xCmd.GET_PROPERTY.DATA5;
	Pro2Cmd[10] = Si446xCmd.GET_PROPERTY.DATA6;
	Pro2Cmd[11] = Si446xCmd.GET_PROPERTY.DATA7;
	Pro2Cmd[12] = Si446xCmd.GET_PROPERTY.DATA8;
	Pro2Cmd[13] = Si446xCmd.GET_PROPERTY.DATA9;
	Pro2Cmd[14] = Si446xCmd.GET_PROPERTY.DATA10;
	Pro2Cmd[15] = Si446xCmd.GET_PROPERTY.DATA11;
	/*Pro2Cmd[16] = Si446xCmd.GET_PROPERTY.DATA12;
    Pro2Cmd[17] = Si446xCmd.GET_PROPERTY.DATA13;
    Pro2Cmd[18] = Si446xCmd.GET_PROPERTY.DATA14;
    Pro2Cmd[19] = Si446xCmd.GET_PROPERTY.DATA15;*/

	radio_comm_SendCmd(NUM_PROPS+4, Pro2Cmd);
}

#endif
