i7sid/SkyNet-Dongle/firmware/src/radio/radio_comm.c

#include "radio_comm.h"
#include "radio_hal.h"

#include "../misc/debug.h"


#if (defined SILABS_RADIO_SI446X) || (defined SILABS_RADIO_SI4455)
uint8_t ctsWentHigh = 0;
#endif

#if (defined SILABS_RADIO_SI446X) || (defined SILABS_RADIO_SI4455)

/*!
 * Gets a command response from the radio chip
 *
 * @param byteCount     Number of bytes to get from the radio chip
 * @param pData         Pointer to where to put the data
 *
 * @return CTS value
 */
uint8_t radio_comm_GetResp(uint8_t byteCount, uint8_t* pData)
{
  uint8_t ctsVal = 0;
  uint16_t errCnt = RADIO_CTS_TIMEOUT;

  while (errCnt != 0)      //wait until radio IC is ready with the data
  {
    radio_hal_ClearNsel();
    radio_hal_SpiWriteByte(0x44);    //read CMD buffer
    ctsVal = radio_hal_SpiReadByte();
    if (ctsVal == 0xFF)
    {
      if (byteCount)
      {
        radio_hal_SpiReadData(byteCount, pData);
      }
      radio_hal_SetNsel();
      break;
    }
    radio_hal_SetNsel();
    errCnt--;
  }

  if (errCnt == 0)
  {
  	DBG("ERROR: CTS takes too long.\n");
    while(1)
    {
      /* ERROR!!!!  CTS should never take this long. */
      #ifdef RADIO_COMM_ERROR_CALLBACK
        RADIO_COMM_ERROR_CALLBACK();
      #endif
    }
  }

  if (ctsVal == 0xFF)
  {
    ctsWentHigh = 1;
  }

  return ctsVal;
}

/*!
 * Sends a command to the radio chip
 *
 * @param byteCount     Number of bytes in the command to send to the radio device
 * @param pData         Pointer to the command to send.
 */
void radio_comm_SendCmd(uint8_t byteCount, uint8_t* pData)
{
    /* There was a bug in A1 hardware that will not handle 1 byte commands. 
       It was supposedly fixed in B0 but the fix didn't make it at the last minute, so here we go again */
    if (byteCount == 1)
        byteCount++;

    while (!ctsWentHigh)
    {
        radio_comm_PollCTS();
    }
    radio_hal_ClearNsel();
    radio_hal_SpiWriteData(byteCount, pData);
    radio_hal_SetNsel();
    ctsWentHigh = 0;
}

/*!
 * Gets a command response from the radio chip
 *
 * @param cmd           Command ID
 * @param pollCts       Set to poll CTS
 * @param byteCount     Number of bytes to get from the radio chip.
 * @param pData         Pointer to where to put the data.
 */
void radio_comm_ReadData(uint8_t cmd, uint8_t pollCts, uint8_t byteCount, uint8_t* pData)
{
    if(pollCts)
    {
        while(!ctsWentHigh)
        {
            radio_comm_PollCTS();
        }
    }
    radio_hal_ClearNsel();
    radio_hal_SpiWriteByte(cmd);
    radio_hal_SpiReadData(byteCount, pData);
    radio_hal_SetNsel();
    ctsWentHigh = 0;
}


/*!
 * Gets a command response from the radio chip
 *
 * @param cmd           Command ID
 * @param pollCts       Set to poll CTS
 * @param byteCount     Number of bytes to get from the radio chip
 * @param pData         Pointer to where to put the data
 */
void radio_comm_WriteData(uint8_t cmd, uint8_t pollCts, uint8_t byteCount, uint8_t* pData)
{
    if(pollCts)
    {
        while(!ctsWentHigh)
        {
            radio_comm_PollCTS();
        }
    }
    radio_hal_ClearNsel();
    radio_hal_SpiWriteByte(cmd);
    radio_hal_SpiWriteData(byteCount, pData);
    radio_hal_SetNsel();
    ctsWentHigh = 0;
}

/*!
 * Waits for CTS to be high
 *
 * @return CTS value
 */
uint8_t radio_comm_PollCTS(void)
{
#ifdef RADIO_USER_CFG_USE_GPIO1_FOR_CTS
    while(!radio_hal_Gpio1Level())
    {
        /* Wait...*/
    }
    ctsWentHigh = 1;
    return 0xFF;
#else
    return radio_comm_GetResp(0, 0);
#endif
}

/**
 * Clears the CTS state variable.
 */
void radio_comm_ClearCTS()
{
  ctsWentHigh = 0;
}

#elif (defined SILABS_RADIO_SI4012)

/*!
 * Gets a command response from the radio chip
 *
 * @param byteCount     Number of bytes to get from the radio chip
 * @param pData         Pointer to where to put the data
 *
 * @return CTS value
 */
uint8_t radio_comm_GetResp(uint8_t byteCount, uint8_t* pData)
{
  SEGMENT_VARIABLE(ctsVal = 0u, uint8_t, SEG_DATA);

  if (qSmbus_SMBusRead(SI4012_SMBUS_ADDRESS, byteCount, pData) != \
                                                          SMBUS_RX_FINISHED) {
    return FALSE;
  }

  if (pData[0] == 0x80) {
    return TRUE;
  }

  return FALSE;
}

/*!
 * Sends a command to the radio chip
 *
 * @param byteCount     Number of bytes in the command to send to the radio device
 * @param pData         Pointer to the command to send.
 */
uint8_t radio_comm_SendCmd(uint8_t byteCount, uint8_t* pData)
{
  if (qSmbus_SMBusWrite(SI4012_SMBUS_ADDRESS, byteCount, pData) != \
                                                      SMBUS_TRANSMISSION_OK) {
    return FALSE;
  }

  return TRUE;
}

#endif

/*!
 * Sends a command to the radio chip and gets a response
 *
 * @param cmdByteCount  Number of bytes in the command to send to the radio device
 * @param pCmdData      Pointer to the command data
 * @param respByteCount Number of bytes in the response to fetch
 * @param pRespData     Pointer to where to put the response data
 *
 * @return CTS value
 */
uint8_t radio_comm_SendCmdGetResp(uint8_t cmdByteCount, uint8_t* pCmdData, uint8_t respByteCount, uint8_t* pRespData)
{
    radio_comm_SendCmd(cmdByteCount, pCmdData);
    return radio_comm_GetResp(respByteCount, pRespData);
}
