i7sid/SkyNet-Dongle/firmware/src/radio/radio_comm.h

/*!
 * File:
 *  radio_comm.h
 *
 * Description:
 *  This file contains the RADIO communication layer.
 *
 * Silicon Laboratories Confidential
 * Copyright 2011 Silicon Laboratories, Inc.
 */
#ifndef _RADIO_COMM_H_
#define _RADIO_COMM_H_


#if defined (__USE_LPCOPEN)
#if defined(NO_BOARD_LIB)
#include "chip.h"
#else
#include "board.h"
#endif
#endif



//#define RADIO_CTS_TIMEOUT 255
#define RADIO_CTS_TIMEOUT 1023
//#define RADIO_CTS_TIMEOUT 10000
//#define RADIO_CTS_TIMEOUT 100000

extern uint8_t radioCmd[16];

#define SILABS_RADIO_SI446X

#if (defined SILABS_RADIO_SI446X) || (defined SILABS_RADIO_SI4455)
uint8_t radio_comm_GetResp(uint8_t byteCount, uint8_t* pData);
void radio_comm_SendCmd(uint8_t byteCount, uint8_t* pData);
void radio_comm_ReadData(uint8_t cmd, uint8_t pollCts, uint8_t byteCount,
		uint8_t* pData);
void radio_comm_WriteData(uint8_t cmd, uint8_t pollCts, uint8_t byteCount,
		uint8_t* pData);

#elif (defined SILABS_RADIO_SI4012)
uint8_t radio_comm_GetResp(uint8_t byteCount, uint8_t* pData);
uint8_t radio_comm_SendCmd(uint8_t byteCount, uint8_t* pData);
#endif

uint8_t radio_comm_PollCTS(void);
uint8_t radio_comm_SendCmdGetResp(uint8_t cmdByteCount, uint8_t* pCmdData,
		uint8_t respByteCount, uint8_t* pRespData);
void radio_comm_ClearCTS(void);

#endif //_RADIO_COMM_H_
