i7sid/SkyNet-Dongle/firmware/src/radio/radio_config.h

/*
 * radio_config.h
 *
 *  Created on: Oct 26, 2013
 *      Author: eckert
 */

#ifndef PRE_RADIO_CONFIG_H_
#define RRE_RADIO_CONFIG_H_


#include "radio_config_868_30MHz_neu1.h"
//#include "radio_config_868_30MHz.h"
//#include "radio_config_868.h"
//#include "radio_config_915.h"

#endif /* RADIO_CONFIG_H_ */
