i7sid/SkyNet-Dongle/firmware/src/skycom/repeater.h

/**
 *  @file
 *
 *  @date 	24.06.2016
 *  @author	Michael Zapf <michael.zapf@fau.de>
 */

#ifndef SKYCOM_REPEATER_H_
#define SKYCOM_REPEATER_H_

#if 0
//#ifdef IS_REPEATER

#endif


#endif /* SKYCOM_REPEATER_H_ */
