i7sid/SkyNet-Dongle/usb-host/src/string_helper.cpp

/**
 * @file
 * @brief   TODO
 *
 * TODO
 *
 * @author  Michael Zapf <michael.zapf@fau.de>
 * @date    2016-06-21
 *
 * Copyright (C) 2016 Michael Zapf <michael.zapf@fau.de>
 */

#include "string_helper.h"

using namespace std;

// trim from start
inline std::string &ltrim(std::string &s) {
        s.erase(s.begin(), std::find_if(s.begin(), s.end(), std::not1(std::ptr_fun<int, int>(std::isspace))));
        return s;
}

// trim from end
inline std::string &rtrim(std::string &s) {
        s.erase(std::find_if(s.rbegin(), s.rend(), std::not1(std::ptr_fun<int, int>(std::isspace))).base(), s.end());
        return s;
}

// trim from both ends
inline std::string &trim(std::string &s) {
        return ltrim(rtrim(s));
}

vector<string> split(const char *str, char c = ' ')
{
    vector<string> result;

    do
    {
        const char *begin = str;

        while(*str != c && *str)
            str++;

        string tmp(string(begin, str));
        result.push_back(trim(tmp));
    } while (0 != *str++);

    return result;
}
