i7sid/SkyNet-Dongle/bootloader/src/main.c

#include <stdint.h>
#include <stdbool.h>
#include "disk.h"
#include "sbl_iap.h"
#include "sbl_config.h"

#include "LPC17xx.h"

bool user_flash_erased;
__attribute__((section(".noinit.$RamBootShared*"))) uint8_t goto_bootloader;


// some basics

typedef struct {				/* GPIO_PORT Structure */
	__IO uint32_t DIR;			/*!< Offset 0x0000: GPIO Port Direction control register */
	uint32_t RESERVED0[3];
	__IO uint32_t MASK;			/*!< Offset 0x0010: GPIO Mask register */
	__IO uint32_t PIN;			/*!< Offset 0x0014: Pin value register using FIOMASK */
	__IO uint32_t SET;			/*!< Offset 0x0018: Output Set register using FIOMASK */
	__O  uint32_t CLR;			/*!< Offset 0x001C: Output Clear register using FIOMASK */
} LPC_GPIO_T;
#define LPC_GPIO                  ((LPC_GPIO_T             *) LPC_GPIO0_BASE)


// LED configuration
#define LED_PORT					1
#define LED_PIN						21

inline void skynet_led(bool on) {
	if (!on) {	/* Set Port */
		LPC_GPIO[LED_PORT].SET |= 1UL << LED_PIN;
	}
	else {	/* Clear Port */
		LPC_GPIO[LED_PORT].CLR |= 1UL << LED_PIN;
	}
}

// USB mass storage driver - in msc_usb_start.c
void usb_msc_start(void);

/*****************************************************************************
 * enter_usb_isp() is the routine called if the bootloader determines that the
 * USB interface needs starting to allow the user to upload a new application
 *  into the LPC1768's flash memory
 *****************************************************************************/
void enter_usb_isp(void) {
    user_flash_erased = false;

    // Generate File Allocation Table to save Flash space
    // First Two FAT entries are reserved
    FAT[0] = 0xF8;
    FAT[1] = 0xFF;
    FAT[2] = 0xFF;
    /* Start cluster of a file is indicated by the Directory entry = 2 */
    uint32_t m = 3;
    uint32_t next_cluster;
    for(uint32_t n = 3; n < NO_OF_CLUSTERS + 2; n += 2) {
        if(n == (NO_OF_CLUSTERS + 2) - 1) {
            next_cluster = 0xFFF;
        } else {
            next_cluster = n + 1;
        }
        FAT[m] = (uint8_t)n & 0xFF;
        FAT[m + 1] = (((uint8_t)next_cluster & 0xF) << 4) | ((uint8_t)(n>>8)&0xF);
        FAT[m + 2] = (uint8_t)(next_cluster >> 4) & 0xFF;
        m += 3;
    }

    /* Correct file size entry for file firmware.bin since user flash size isn't
     * know until runtime.
     */
    DIRECTORY_ENTRIES[1].filesize = USER_FLASH_SIZE;

    // Start up LPCUSB mass storage system to allow user to copy
    // their application binary to the LPC1768's flash.
    usb_msc_start ();

    // Note - should never actually return from usb_msc_start ().
}

/*********************************
 * Main entry point for bootloader
 *********************************/

int main (void) {
    //initialize_logging();

    // init led
    LPC_GPIO[LED_PORT].DIR |= 1UL << LED_PIN;
	skynet_led(true);

	// DEBUG
	//goto_bootloader = 0xAA;

    // Check to see if there is a user application in the LPC1769's flash memory.
    //if(user_code_present()) {
    if(user_code_present() && goto_bootloader != 0xAA) {
        // There is an application, but need to check if user is pressing the button
        // to indicate they want to upload a new application.
        //check_isp_entry_pin();

    	execute_user_code();
    }

    // reset goto_bootloader flag so on next startup we boot user code (if present)
    goto_bootloader = 0;

    // User code not present or isp entry requested
    enter_usb_isp();

    // Note - should never actually return from enter_usb_isp ().
    while (1);        // loop forever
    return 0;
}

void eject(void) {
	skynet_led(false);
	// check integrity

	// goto user program next time
	goto_bootloader = 0x00;

	// wait some time for sure...
	for (volatile unsigned int i = 0; i < 5000000; ++i) { __asm volatile("nop"); }


	// reset (adapted from core_cm3.h from lpc_chip_175x_6x)
	__asm volatile ("dsb"); // Ensure all outstanding memory accesses included buffered write are completed before reset
	SCB->AIRCR = ((0x5FA << SCB_AIRCR_VECTKEY_Pos) |
				 (SCB->AIRCR & SCB_AIRCR_PRIGROUP_Msk) |
				 SCB_AIRCR_SYSRESETREQ_Msk);   // Keep priority group unchanged
	__asm volatile ("dsb");                     // Ensure completion of memory access
	while(1);                                  // wait until reset

}
