i7sid/SkyNet-Dongle/(commit log)

2014-05-26 initial commit (schematics)
    + first version of README.md
    + first sketch of schematics
    TODO on schematics:
    + power supply, charging and battery interfacing
    [SkyNetV3main.sch]
2014-06-10 further schematics development; layout started
    [SkyNetV3main.brd, SkyNetV3main.sch]
2014-06-10 further layout, got stuck somewhere...
    [SkyNetV3main.brd, SkyNetV3main.sch]
2014-06-10 board further
    [SkyNetV3main.brd]
2014-06-10 added ground planes
    [SkyNetV3main.brd, SkyNetV3main.sch]
2014-06-11 layout optimizations, tStop corrected
    [SkyNetV3main.brd, SkyNetV3main.sch]
2014-06-13 new layout
    [SkyNetV3main.brd, SkyNetV3main.sch]
2014-06-15 another layout try, looks much better now
    [SkyNetV3main.brd, SkyNetV3main.sch]
2014-06-16 layout improvements
    [SkyNetV3main.brd, SkyNetV3main.sch]
2014-06-16 corrected USB connector in layout+schematics
    [SkyNetV3main.brd, SkyNetV3main.sch]
2014-06-16 usb2seriel adapter for debugging and firmware uploading
    [usb2rs232_v2.3.brd, usb2rs232_v2.3.sch]
2014-06-17 corrected some distance problems and missing VALUEs
    [SkyNetV3main.brd, SkyNetV3main.sch]
2014-08-15 some further firmware work
    + RF working
    + bluetooth basically working
    TODO:
    - switch on / off
    - ...
2014-08-18 layout & schematic fixes
    + layout: better ground flow
    + layout: more space for single parts
    + layout: marked GND on battery
    + layout: marked pinouts
    + schematics: fixed USB-connect->USB-plus connection
    [SkyNetV3main.brd, SkyNetV3main.sch]
2014-10-02 lots of iterative firmware improvements
    for example:
    - bluetooth improved
    - charger now detects usb port type
2014-10-11 board: connected PS/SYNC of buck boost converter
    [SkyNetV3main.brd, SkyNetV3main.sch]
2014-10-14 Connected PS/SYNC of DC/DC
    [SkyNetV3main.brd]
2014-11-07 Schematic revised. TODO Radio remains
    [SkyNetV3main.brd, SkyNetV3main.sch]
2014-11-13 Schematic revised
    [SkyNetV3main.brd, SkyNetV3main.sch]
2014-11-14 psu done
    [SkyNetV3main.brd, SkyNetV3main.sch]
2014-11-15 firmware: Check "is BT connected" via GPIO
    behaviour was: enable AT mode, ask, disable AT mode
    (was very unstable!)
    [main.c, sysinit.c]
2014-11-17 cpu moved
    [SkyNetV3main.brd, SkyNetV3main.sch]
2014-11-24 routing done
    [SkyNetV3main-1.brd, SkyNetV3main-1.sch]
2014-11-24 cleanup after routing
    [SkyNetV3main-1.brd, SkyNetV3main-1.sch, SkyNetV3main.brd, SkyNetV3main.sch]
2014-11-24 battery polarity revised
    [SkyNetV3main.brd, SkyNetV3main.sch]
2014-11-27 new connector
    [SkyNetV3main.brd, SkyNetV3main.sch]
2014-12-01 case added
    [v3.1.button.stl, v3.1.lowerCase.stl, v3.1.scad, v3.1.upperCase.stl]
2015-01-13 added support for usb pocket
    [v3.1.button.stl, v3.1.lowerCase.stl, v3.1.scad]
2015-01-13 position adjustments
    [v3.1.button.stl, v3.1.lowerCase.stl, v3.1.scad, v3.1.upperCase.stl]
2015-01-13 added todos
    [v3.1.scad]
2015-01-16 first try of breakout board
    [board_breakout.brd, board_breakout.sch]
2015-01-20 breakout board now one-sided
    [board_breakout.brd, board_breakout.sch]
2015-01-22 adapted firmware to new board
2015-01-22 net names corrected for led
    [SkyNetV3main.brd, SkyNetV3main.sch]
2015-01-29 next iteration
    [v3.1.button.stl, v3.1.lowerCase.stl, v3.1.scad, v3.1.upperCase.stl]
2015-01-29 reduzed button radius
    [v3.1.button.stl, v3.1.scad]
2015-02-02 Revert "net names corrected for led"
    This reverts commit bfdfdada0646938294157fc6761012cd3f7e2628.
    nets got damaged by renaming, better just adopt firmware instead
    [SkyNetV3main.brd, SkyNetV3main.sch]
2015-02-02 breakout board added header
    [board_breakout.brd, board_breakout.sch]
2015-02-02 slightly adjusted to new board, no bootloader
    currently the memory map is configured such that
    no usb bootloader should be installed
    (for development and testing purposes)
2015-02-07 some debugging stuff added (testing current consumption)
2015-02-09 added mounting holes
    [SkyNetV3main.brd, SkyNetV3main.sch, v3.1.lowerCase.stl, v3.1.scad, v3.1.upperCase.stl]
2015-03-04 debug stuff added
    [v3.1.scad]
2015-04-01 mini dongle added
    [SkyNetV3.1.brd, SkyNetV3.1.sch]
2015-04-07 improved placement
    [SkyNetV3.1.brd]
2015-04-14 almost done
    [SkyNetV3.1.brd, SkyNetV3.1.sch]
2015-04-15 mitten drin
    [SkyNetV3.1.brd, SkyNetV3.1.sch]
2015-04-23 power down @ critical power level added
    [SkyNetV3.1.brd]
2015-04-29 implemented mutex and synchronisation of adc access
2015-05-07 fixed gpio interrupt
2015-06-11 bugfixing, cleanup, gpiointerrupt, doku, gpsmodul
    [adc.c, compass.c, compass.h, gpio_irq.c, main.c, skynet_radio.c]
2015-06-24 ported to board version 3.1
2015-07-10 Some funktionalities of the Communikation Protokoll and bug fixing
    [config.h]
2015-10-23 first successfull usb cdc test; LED: adjusted to single
2015-10-25 usb cdc driver interface, event added
2015-11-09 adjusted led
2015-12-04 host: added method to reset device
    [SkyNet-USB-Host.cpp]
2016-02-04 small fix, test added
    [mac_frame_ack.h, mac_frame_data.h]
2016-02-05 frame stuff, csma stuff
2016-02-05 adjusted some mac stuff to board
2016-02-08 added bash script to create tap device
2016-03-15 mac packet assembly further
2016-04-06 fixed usb not reconnecting, minor cleanup
    [main.c, skynet_cdc.c]
2016-04-06 small fixes/workarounds, TAP testing
    [SkyNet-USB-Host.cpp, mac.c, mac_frame_data.c, main.c, skynet_radio.c]
2016-04-08 mac data frame: unpack method; host: some stuff
2016-04-08 host: error handling improved
    [SkyNet-USB-Host.cpp]
2016-04-08 fixed some host issues
    [SkyNet-USB-Host.cpp, main.c, skynet_cdc.c, tap.cpp, tap.h]
2016-04-09 fixed bug with fstream in host app
    [SkyNet-USB-Host.cpp, usbtty.cpp, usbtty.h]
2016-04-09 added sysctl call to setup-tap-script
    avoid problems with reverse packet filter
2016-04-12 fixed bug in mac addresses
    [SkyNet-USB-Host.cpp]
2016-04-13 dbg host: try to correct bug in previous workaround
    [SkyNet-USB-Host.cpp]
2016-04-14 host: if usb packet too long, don't ignore all following, but wait for next
    [usbtty.cpp]
2016-04-19 bug with queue fixed
    [SkyNet-USB-Host.cpp, usbtty.cpp]
2016-04-20 host: bug in memory allocation fixed
    [SkyNet-USB-Host.cpp]
2016-04-28 fixed malloc size bug in extheader unpack
    [SkyNet-USB-Host.cpp, mac_frame_data.c]
2016-04-30 compass calibration works
2016-05-03 main.c for basestation fix
    [main.c]
2016-05-04 removed bug in radio TX
    Hooray!
    + many gui features...
    [SkyNet-USB-Host.cpp, mac_payload_types.h, main.c]
2016-05-06 applied si4463 patch, minor fixes
    [radio.c, si446x_api_lib.c, skynet_radio.c]
2016-05-07 found problem (was crc) + some debug stuff
    [mac.c, mac_frame_data.c, main.c, radio.c, radio.h, skynet_radio.c, util.h]
2016-05-07 possible workaround for weird packet handler bug
    clear tx fifo after TX by manually writing 0x0
    [mac_frame_data.c, main.c, skynet_radio.c]
2016-05-07 firmware: added -Werror, warnings=errors
    + adjusted code to compile
    [radio_comm.h, si446x_api_lib.c]
2016-05-11 write sensor data to text file (for sure)
2016-05-11 fixed bug in wind speed: got never null
    [windspeed.c]
2016-05-12 radio pa level config msg; fixed host compile bug
    [SkyNet-USB-Host.cpp, mac_payload_types.h, main.c, rf_pkt_handler.c, skynet_radio.c]
2016-05-12 base: fixed bug in auto-mac routine
    [main.c]
2016-05-17 fixed missing free() in firmware
    [gps.c, mac_frame_data.c, mac_frame_data.h, main.c, rf_pkt_handler.c, skynet_cdc.c]
2016-06-16 fixed bug in compass calibration; send winddir raw
    [compass.c, mac_payload_types.h, main.c]
2016-06-16 gui: added function to stop calibration manually
2016-06-21 rf power test
2016-06-21 added better output framework, basic station output json
2016-06-30 fixed some retransmission issues; added basic multihop (ttl=2)
    [mac.c, mac.h, mac_config.h, main.c, rf_pkt_handler.c, seen_packet.c, seen_packet.h, skycom.c]
2016-07-02 removed debug (lead to bug)
    [station.cpp]
2016-07-13 fixed little bug in windspeed
    [windspeed.c]
2016-08-01 UART between base and feather works
2016-08-03 base with feather: works basically
    problem: multiple received packets are recognized multiple times
    [dfx.c, dfx.h, mac_frame_data.c, main.c, skybasefeather.ino, skymac.h, skynetfeather.ino]
2016-08-03 host filters out packets that were received multiple times
2016-08-05 send base to feather even if gps fix missing
    [main.c]
2016-09-05 feather: fixed mac bug, mac in library; multihop
    [config.h, rf_packet_handler.cpp, rf_packet_handler.h, skybasefeather.ino, skymac.cpp, skymac.h, skynetfeather.ino]
2016-09-08 fixed some fifo issues, fixed which data is transmitted
    [main.c, skybasefeather.ino]
2016-09-20 environment for analysis added
    [starts-2016-09-09-11-07-32.csv, wind-data-2016-09-09-11-07-32.csv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]
2016-10-31 analysis environment updates
    [starts-2016-07-08-09-12-35.csv, starts-2016-07-19-09-33-49.csv, wind-data-2016-07-08-09-12-35.csv, wind-data-2016-07-19-09-33-49.csv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]
